tdarlic/magniplacer/feeders/PushPullFeeder-assembly.png

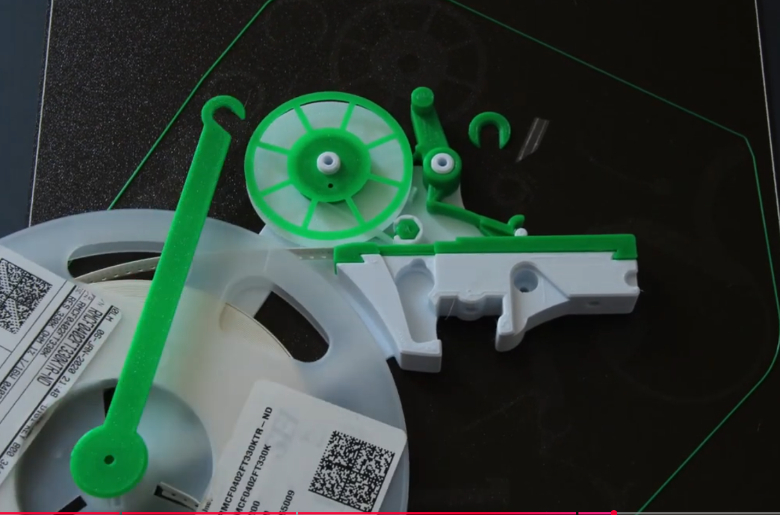
feeders/PushPullFeeder-assembly.png
