tdarlic/magniplacer/images/o-ring-image-on-ruler.jpg

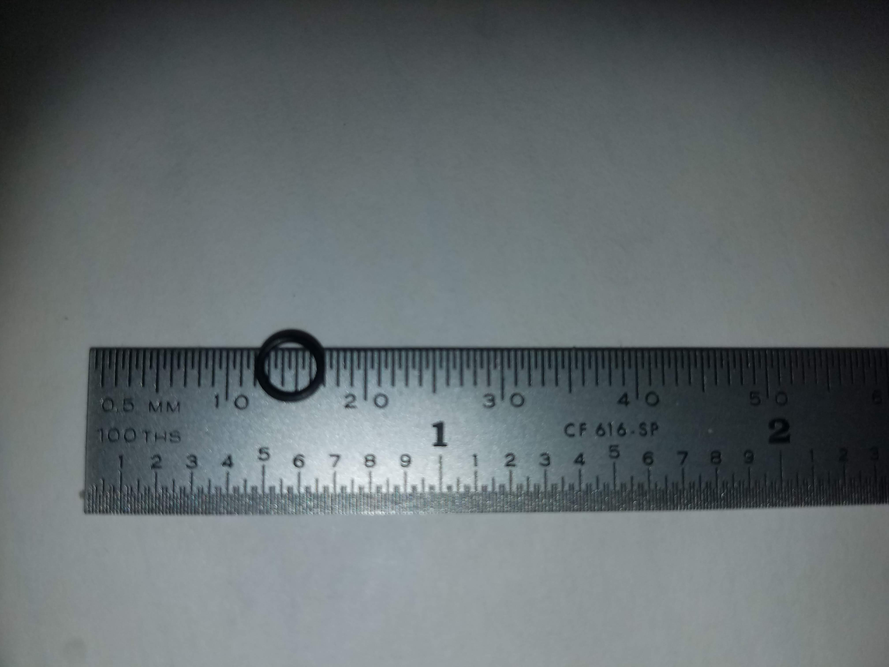
images/o-ring-image-on-ruler.jpg
