tdarlic/magniplacer/openpnp-machine-notes.md

# OpenPnP machine – upgrade to 2.6, cameras, lighting and vacuum sensing

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

**Contents**

1. [Machine overview and access](#1-machine-overview-and-access)
2. [Upgrade from OpenPnP v1 to 2.6](#2-upgrade-from-openpnp-v1-to-26)
3. [Bottom (up-looking) camera – placement and height](#3-bottom-up-looking-camera--placement-and-height)
4. [Bottom camera – alignment and calibration](#4-bottom-camera--alignment-and-calibration)
5. [Bottom camera lighting](#5-bottom-camera-lighting)
6. [Vacuum sensing – design](#6-vacuum-sensing--design)
7. [Vacuum sensing – as built on this machine](#7-vacuum-sensing--as-built-on-this-machine)
8. [Vacuum sensing – Smoothieware config](#8-vacuum-sensing--smoothieware-config)
9. [Vacuum sensing – OpenPnP config and part detection](#9-vacuum-sensing--openpnp-config-and-part-detection)
10. [Troubleshooting](#10-troubleshooting)
11. [Change log – what was changed on the machine](#11-change-log--what-was-changed-on-the-machine)
12. [Open items](#12-open-items)
13. [References](#13-references)

---

## 1. Machine overview and access

| Item | Value |
|---|---|
| PC | hostname `openpnp`, Ubuntu 24.04, `ssh tdarlic@192.168.0.185` (password login, no SSH key installed yet) |
| OpenPnP | 2.6 (`2.6_2026-03-01_12-37-59.5bd404c`), installed in `/opt/openpnp`, Java 21 (OpenJDK) |
| Live OpenPnP config | `~/.openpnp2/` |
| First-run default config | `~/.openpnp2-clean/` (untouched, for reference) |
| Old v1 config | USB stick `/media/tdarlic/0E86-A3E6/.openpnp/`; identical copy in `~/Documents/.openpnp/` (**not read by 2.6**) |
| Controller | Smoothieboard v1.1 (LPC1769), OpenPnP driver `GcodeAsyncDriver` named "GcodeDriver" |
| Smoothie config | `config.txt` on the Smoothie SD card; on the PnP PC it mounts as `/media/tdarlic/A620-C10D/config.txt` |
| Serial port | `/dev/ttyACM0`, 115200 baud (Smoothieboard USB `1d50:6015`) |
| Nozzle | `N` (id `N1`), `ContactProbeNozzle`, probe actuator `N1PROBE` (G38.2, reads P1.29 via M119) |
| Nozzle tips | 6 tips in an automatic tip changer: N045 (`NT1`), N40, N14, N24, N400, N750 (see below) |
| Top camera | `TOP CAMERA`, Logitech C270 (`046d:0825`), USB port `usb-0000:00:14.0-9`, 1280×960 |
| Bottom camera | `BOTTOM`, "HD USB Camera" (`05a3:9310`), USB port `usb-0000:00:14.0-2`, 960×720 |

### Actuators (v2 config)

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

### Configuration as checked on 2026-10-05

**Axes and motion** (`GcodeAsyncDriver`, motion control `ModeratedConstantAcceleration`, machine speed slider 100 %)

| Axis | Letter | Soft limits | Notes |
|---|---|---|---|
| x | X | 1 … 570 mm | **200 mm/s, 1200 mm/s²** (tested, 2026-10-05); backlash: one-sided, ≈ 0.127 mm |
| y | Y | 3 … 373 mm | **200 mm/s, 1200 mm/s²** (tested, 2026-10-05); backlash: one-sided, ≈ 0.127 mm |
| Z | Z | – | safe zone low −4.8 mm |
| C | A | −180 … 180° | rotation, wrap-around, limited |
| zTop / rotationTop | – | – | virtual axes for the top camera |

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

**Cameras**

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

Nozzle head offset (to the top camera): X −106.55, Y −35.47.

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

**Feeders and parts**

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

**Smoothie `config.txt`** (main values, file dated 2026-10-05 16:33)

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

### Working rules

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

---

## 2. Upgrade from OpenPnP v1 to 2.6

### Approach

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

### What was found

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

### Old v1 config – for reference

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

### What to carry over

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

### Suggested order

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

---

## 3. Bottom (up-looking) camera – placement and height

### The top and bottom cameras never need to look at each other

Both cameras are referenced to the **nozzle**, not to each other:

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

So what matters is where the **nozzle** can reach, not the top camera.

### Placement

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

### Height and focus

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

---

## 4. Bottom camera – alignment and calibration

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

**Reason:** two separate things decide that point:

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

**Procedure:**

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

**Investigate mechanically only if:**

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

---

## 5. Bottom camera lighting

### Decision

The bottom camera light was **changed from red LEDs to white LEDs.**

### Why white rather than red (or 617 nm "amber")

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

### Setting the brightness – not as bright as possible

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

Notes:

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

---

## 6. Vacuum sensing – design

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

**Parts:** NXP/Freescale **MPXV6115VC6U** vacuum sensor + Microchip **MCP6001UT-I/OT** op-amp.

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

### Signal chain

```
vacuum line ── MPXV6115V   (5 V supply, 4.6 V at atmosphere → 0.2 V at full vacuum)
                   │
             divider 51k / 100k  (× 0.662)  + RC low-pass
                   │
             MCP6001U voltage follower  (3.3 V supply, rail-to-rail)
                   │
             100 Ω → Smoothieboard P0.23 (T0 thermistor input, LPC1769 ADC 0–3.3 V)
                   │
             Smoothieware temperature_control (ad8495 = linear)  →  M105  →  OpenPnP actuator AVACS
```

### Design decisions

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

### Op-amp choice – history

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

### Schematic

```
 +5V (from Smoothie serial debug header – see §7)
  │
  ├──────────┬──────────────┐
  │          │              │
  │       C1 100nF       C2 1.5µF (optional, bulk)
  │          │              │
  │         GND            GND
  │
  │   ┌───────────────┐
  └───┤ 2  Vs         │
      │               │
      │  MPXV6115VC6U │ 4  Vout
      │  (U1)         ├──────┬────── R1 51k ─────┬────────────────┐
      │               │      │                  │                │
      │ 3  GND        │   C3 33pF           R2 100k    C4 22nF   │
      └──────┬────────┘      │                  │         │      │
             │              GND                GND       GND     │
            GND                                                  │
   (pins 1, 5, 6, 7, 8: leave unconnected)                       │
                                                                 │
 +3.3V (from Smoothie VBB/3.3V/GND connector – see §7)           │
   │                                                             │
   ├──────────────────────────────── 5  VDD                      │
   │                                                             │
 C5 100nF                   ┌─ 1  VIN+ ◄─────────────────────────┘
 (≤ 2 mm from pin 5)        │
   │                        │    MCP6001UT-I/OT  (U2, SOT-23-5)
  GND                       │
                       ┌─── 3  VIN−
                       │
                       │    4  VOUT ──┬── R3 100Ω ────► Smoothie P0.23 (T0 signal pin)
                       │              │
                       └──────────────┘
                            2  VSS ── GND
```

The MCP6001U is wired as a **voltage follower**: output connected straight to VIN−, gain = 1.

### Pinouts (checked against datasheets)

**MPXV6115VC6U (SOP-8, pin 1 marked by notch)**

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

**MCP6001UT-I/OT (SOT-23-5) – "U" variant**

| Pin | Function |
|---|---|
| 1 | VIN+ |
| 2 | VSS (GND) |
| 3 | VIN− |
| 4 | VOUT |
| 5 | VDD (+3.3 V) |

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

### Bill of materials

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

### Expected voltages

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

### Bench test (repeat after any repair)

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

---

## 7. Vacuum sensing – as built on this machine

### Electrical connections to the Smoothieboard v1.1

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

Notes:

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

### Air line

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

```
pump ── restriction (short section of thinner tube) ──┬── sensor (≈ 10 cm from the nozzle holder)
                                                      ├── vent valve AVAC (to outside air)
                                                      └── nozzle
```

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

It works like an air version of a voltage divider:

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

Tuning:

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

### Measured readings (smallest nozzle tip NT1, restriction fitted)

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

Larger tips will read closer to 614 when empty, so their gap will be bigger.

---

## 8. Vacuum sensing – Smoothieware config

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

```
temperature_control.vacuum.enable          true
temperature_control.vacuum.sensor          ad8495
temperature_control.vacuum.ad8495_pin      0.23      # ADC pin of the thermistor input used (T0)
temperature_control.vacuum.ad8495_offset   0
temperature_control.vacuum.designator      V
temperature_control.vacuum.heater_pin      nc
temperature_control.vacuum.max_temp        1000      # MUST be above 660 - see instructions
```

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

---

## 9. Vacuum sensing – OpenPnP config and part detection

### Applied to `~/.openpnp2/machine.xml` (2026-09-29)

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

The XML added to the driver's `<commands>`, in case it needs to be recreated:

```xml
<command head-mountable-id="A1" type="ACTUATOR_READ_COMMAND">
   <text><![CDATA[M105 ; read vacuum sensor]]></text>
</command>
<command head-mountable-id="A1" type="ACTUATOR_READ_REGEX">
   <text><![CDATA[.*V:(?<Value>-?\d+\.?\d*).*]]></text>
</command>
```

### Starting part-detection values – nozzle tip NT1 (set in the GUI)

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

### What is actually configured (checked 2026-10-05)

The starting values above were **not** applied as written. Current settings in `machine.xml`:

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

### Setting up another nozzle tip

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

---

## 10. Troubleshooting

| Symptom | Likely cause |
|---|---|
| Op-amp output stuck at 3.3 V at atmosphere | Divider not working (R1 missing or wrong – this happened during the build) |
| VOUT doesn't follow VIN+ | Wrong MCP6001 variant (plain or R instead of U), or VIN− not tied to VOUT |
| Machine HALTs after boot | `max_temp` missing or below 660 in the `vacuum` section |
| AVACS reads nothing / error | Regex doesn't match: set driver log level to TRACE and check the `M105` reply. Or Smoothie not reset after editing `config.txt` |
| Reading doesn't change | Wrong ADC pin in config, sensor pins 1/5–8 connected, sensor 5 V missing |
| Same reading with tip open and blocked | Restriction between pump and line missing or too wide |
| Reading stuck at ~3.3 V (≈ 660) | Divider R2 missing, or sensor output disconnected |
| Reading stuck near 0 V | Sensor 5 V missing, R1 open, or op-amp not powered |
| Noisy reading | Missing C4/C5, pump/valve/motor current in the sensor ground wire, cable next to stepper cables |
| Reading drifts over time | 5 V not stable (USB power), sensor warming up |
| Output oscillates (check with a scope) | R3 missing or shorted |
| Vacuum builds too slowly / weak pick | Restriction too narrow; leaks in tubing |
| Op-amp or Smoothie dead after rework | Check the VBB/3.3V/GND connector wiring – VBB on the 3.3 V wire |
| Smoothie gives no serial port (`ttyACM0`) and no SD drive; PC log shows `Product: Smoothie`, `Manufacturer: SmoothieWare`, `bcdDevice 0.40` instead of `Smoothieboard` / `Uberclock` | Board waiting in its bootloader. **Most likely cause: e-stop pressed at power-up.** The e-stop is on `kill_button_pin 2.12`, the same pin as the board's play button, which (probably) makes the bootloader wait. Release the e-stop and reset / power-cycle. If it still stays in the bootloader: copy `FIRMWARE.CUR` to `firmware.bin` on the SD card to reflash (2026-10-05) |
| PC says the Smoothie SD card "was not properly unmounted" | The card's FAT dirty flag. Close OpenPnP, `udisksctl unmount -b /dev/sdb1`, `sudo fsck.vfat -a /dev/sdb1`, reset the board. After editing `config.txt` run `sync` before resetting |

---

## 11. Change log – what was changed on the machine

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

---

## 12. Open items

### Next session (2026-10-06): bottom camera Advanced Calibration

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

Before starting:

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

Calibration with a larger tip:

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

Afterwards:

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

### Other open items

- [x] ~~Actuators without a driver~~: PUMP, AVAC, LIGHT_TOP and LIGHT_BOTTOM still have no `driver-id`, but the
      log (2026-10-05) shows their G-code is sent. Nothing to fix. Optionally assign the GcodeDriver for tidiness.
- [x] Bottom camera added, Advanced Camera Calibration enabled, nozzle tip calibration running (N40).
- [ ] **Bottom camera Advanced Calibration is off** (2026-10-05) – redo it, see the checklist at the top of this
      section.
- [x] Top camera Advanced Camera Calibration done and enabled (2026-10-05 19:34, RMS 1.89 px).
- [ ] Set the bottom camera exposure and lighting (§5), then recalibrate.
- [ ] Part detection: set up N045 properly (its method is Difference with no limits). Measure N40 empty and with
      a part, then lower its Part On high limit (590). Set up the other tips. Test with a pick from an empty slot.
- [ ] Confirm what `M800` does to AVAC: does it close the vent? OpenPnP has it on while holding a part.
- [ ] Decide whether the pump runs constantly or is switched for each pick. If switched, set a pump-on wait (§7).
- [ ] Re-copy `machine.xml` into this folder after closing OpenPnP, so the vacuum fix from 2026-10-05 is included.
- [ ] Merge the rest of the v1 `parts.xml` / `packages.xml` into `~/.openpnp2` (only 6 parts so far).
- [ ] Recreate the 15 production strip feeders (table in §2). Only `Upper Strips - 1` exists.
- [ ] Check that the Smoothie 5 V rail isn't fed only from USB.
- [ ] E-stop box: add an indicator LED that shows when the e-stop is pressed. Use a separate NO contact block, with
      the LED on 24 V (24 V indicator, or LED + 2.2 kΩ 0.5 W). **Never load the P2.12 signal line**: it's only held
      high by a pull-up, and an LED there can make the board read "pressed" (machine halts, or stays in the
      bootloader at power-up). Consider also cutting the 24 V motor supply with the e-stop (relay/contactor); the
      kill button is only a firmware halt.
- [x] **Lost steps at 100 % speed** – **solved 2026-10-05**, settings applied at 19:10 (see the end of this item) (fine at 80 %, which also means 64 % acceleration – OpenPnP scales acceleration
      by speed²). X/Y motors are 17HM19-2004S (0.9°, 2.0 A) but run at 0.5 / 0.6 A (`alpha/beta_current`).
      Raise the current, then run `scripts/Speed_Test.js` (copy to `~/.openpnp2/scripts/`). It steps up feed rate
      and acceleration and checks the homing fiducial after each step. Set the axis limits from the result.
      Also: 333 mm/s × 320 steps/mm ≈ 107 kHz, which is above `base_stepping_frequency 100000`.
      Status 2026-10-05: more current made it *worse* (1.2 A clicking at standstill, 0.9 A large lost steps even at
      100 mm/s / 500 mm/s²). Not the supply (Artesyn LCM600Q, 24 V 23 A) and not driver heat (heatsinks fitted).
      Still to check: motor connectors and wiring, the board. At 0.5 / 0.6 A, Y drifted ≈ 0.02 mm per test step at
      every speed → check the Y pulley grub screws and belt tension. Next: baseline speed test at 0.5 / 0.6 A.
      **Finding 2026-10-05 18:33:** the speed test moves at 100 mm/s were fine, but the move back to the fiducial at
      the normal limits (`F29743` requested → Smoothie cap 333 mm/s, only 781 mm/s²) lost so many steps that the
      fiducial was out of view. So **top speed is the problem, not acceleration**: OpenPnP X/Y feed rate is
      15000 mm/s (= unlimited), so every long move runs at Smoothie's 333 mm/s (≈ 500 rpm, ≈ 107 kHz step rate).
      The 0.9 A run failed the same way, so it doesn't prove that more current is worse. Fix: limit the X/Y feed rate
      in OpenPnP (Machine Setup → Axes → x / y → Feed Rate [/s]) to what the speed test shows is safe.
      **Speed test 2026-10-05 18:38** (0.5 / 0.6 A, 1000 mm/s², `speed-test-2026-10-05_1838.csv`): 100, 150, 200
      and 250 mm/s all OK (shift ≤ 0.02 mm = noise, Y drift gone); 300 mm/s lost steps badly (fiducial lost).
      → Set X/Y feed rate **200 mm/s** in OpenPnP and `x/y_axis_max_speed 15000` (250 mm/s) in Smoothie.
      **Acceleration test 2026-10-05 18:52** (200 mm/s, `speed-test-2026-10-05_1852.csv`): 1000, 1500, 2000 mm/s²
      OK (≤ 0.02 mm); 3000 mm/s² lost steps in the first cycle (Y +4.0 mm, X −0.7 mm).
      → Chosen settings: **X/Y 200 mm/s, 1200 mm/s²** (60 % of the last good acceleration).
      OpenPnP: x / y Feed Rate [/s] 200, Acceleration [/s²] 1200. Smoothie: `x/y_axis_max_speed 15000`,
      `acceleration 1200` (used for moves OpenPnP doesn't send an M204 with, e.g. manual G-code).
      **Confirmed 2026-10-05 19:00** (`speed-test-2026-10-05_1900.csv`): 10 cycles at 200 mm/s / 1200 mm/s², total
      shift 0.022 mm (= noise) → no lost steps. **Applied 19:10:** OpenPnP x / y 200 mm/s, 1200 mm/s²; Smoothie
      `x/y_axis_max_speed 15000`, `acceleration 1200`. Copies in this folder: `machine.xml`, `smoothie-config.txt`.
      Optional later: re-test 250/300 mm/s at 0.9 A to confirm the step-rate limit, and the 0.9 A stuttering.
- [x] ~~X/Y low soft limits were switched off~~ (seen in the 18:25 save) – turned back on, saved 19:15.
      **Most likely cause of the 300 mm/s limit: Smoothie's step rate.** `base_stepping_frequency 100000` is the
      Smoothieware default and "the only officially supported value" (smoothieware.org/configuration-options).
      Step pulses are derived from that 10 µs tick by integer division, so the max step rate per motor is
      100000 / 320 = **312 mm/s**, and close to it the step timing becomes very uneven (300 mm/s = 96 kHz).
      Smoothie's `x/y_axis_max_speed 20000` (333 mm/s) is above what it can step. Torque is less likely: X/Y run
      at only ≈ 450 rpm at 300 mm/s (0.9°, 1/32 microstepping, 40 mm/rev). A re-test of 250/300 mm/s at 0.9 A
      would confirm: if 300 still fails, it's the step rate. Going faster needs fewer steps/mm (1.8° motors →
      160 steps/mm → 625 mm/s max), not more current.
- [ ] Optional: `ssh-copy-id tdarlic@192.168.0.185` for password-free access (still no key installed).
- [x] ~~Delete the big vision debug image folder~~: `ImageWriteDebug` is gone. `VisionSolutions` is now 1.7 GB;
      exclude it from backups or clean it up.

---

## 13. References

- Vacuum sensor PCB document: `vacuum-sensor.md` (GitHub vacuum sensor PCB project)
- Reference copy of the OpenPnP machine config: `machine.xml` (this folder; live file is `~/.openpnp2/machine.xml`)
- OpenPnP 2.0 upgrade notes: `/opt/openpnp/OPENPNP_2_0.md` on the PnP PC
- OpenPnP wiki – Vacuum Sensing: <https://github.com/openpnp/openpnp/wiki/Setup-and-Calibration_Vacuum-Sensing>
- Smoothieware temperature control (incl. AD8495 section): <https://smoothieware.org/temperaturecontrol>
- Microchip MCP6001/1R/1U/2/4 datasheet (DS20001733L):
  <https://ww1.microchip.com/downloads/en/DeviceDoc/MCP6001-1R-1U-2-4-1-MHz-Low-Power-Op-Amp-DS20001733L.pdf>
- Microchip MCP6006/6R/6U/7/9 datasheet (MCP6007 alternative):
  <https://ww1.microchip.com/downloads/aemDocuments/documents/APID/ProductDocuments/DataSheets/MCP6006-6R-6U-7-9-Data-Sheet-20006411B.pdf>
- Freescale/NXP MPXV6115V datasheet (Rev 3): <https://docs.rs-online.com/6ca8/0900766b810bd3f3.pdf>
- ST datasheet for MPXV6115V6 / MPXV6115VC6 (second source): <https://www.st.com/resource/en/datasheet/mpxv6115v6.pdf>
