tdarlic/magniplacer/feeders/push-pull-feeder-liteplacer-adapter.png

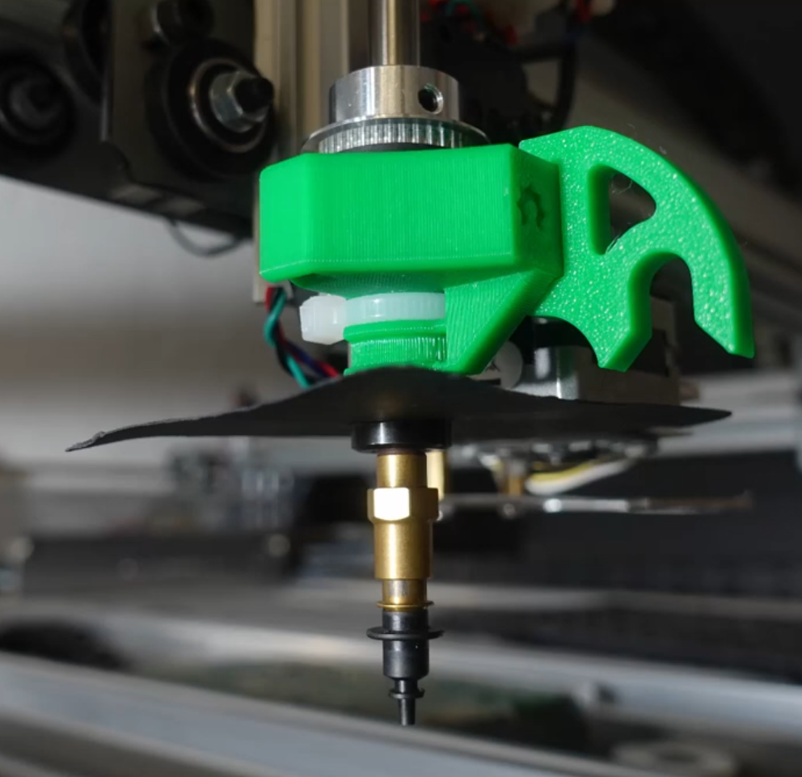
feeders/push-pull-feeder-liteplacer-adapter.png
