tdarlic/magniplacer/images/nozzle_with_ring_off.jpg

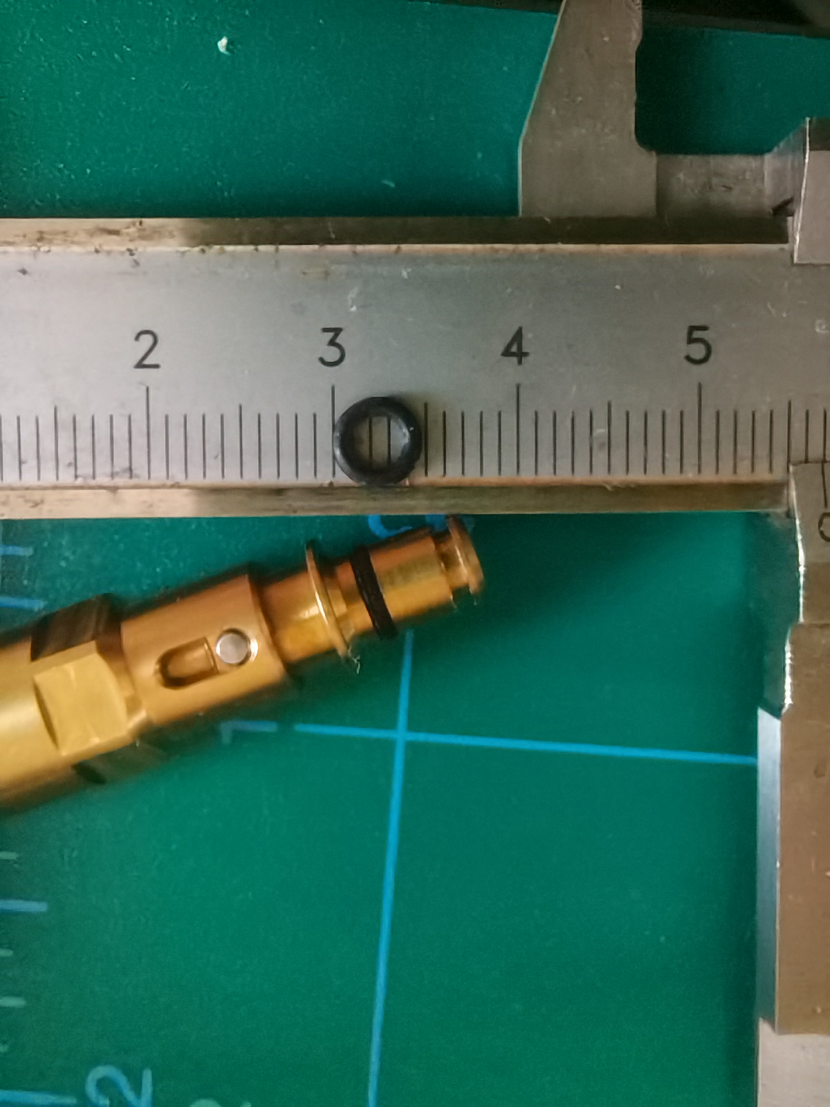
images/nozzle_with_ring_off.jpg
