tdarlic/magniplacer/images/o-ring.jpg

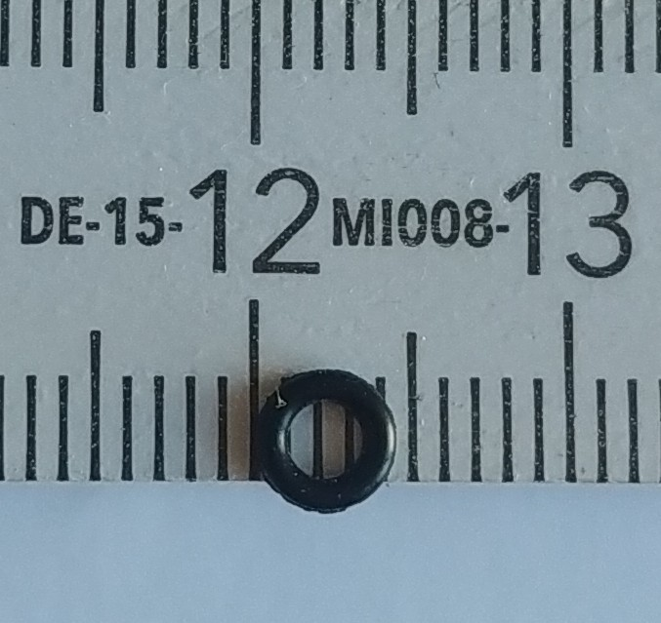
images/o-ring.jpg
