tdarlic/magniplacer/images/Seal_size_3.8-5.2mm.png

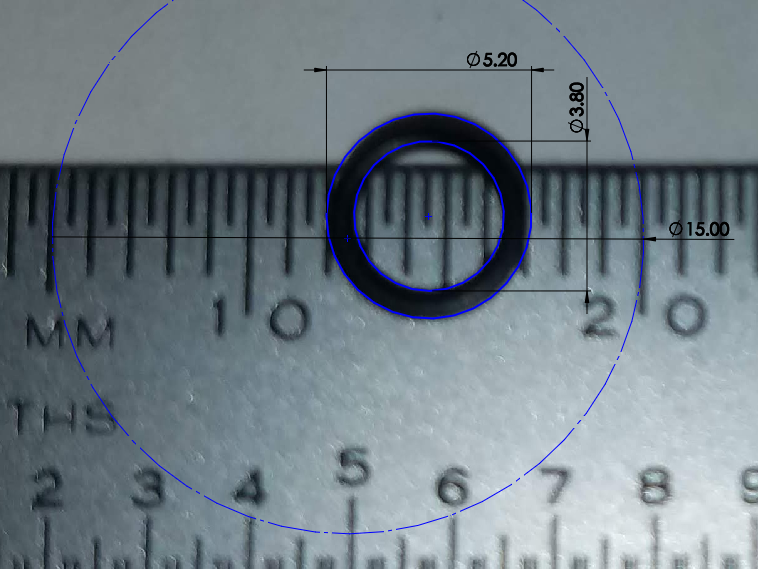
images/Seal_size_3.8-5.2mm.png
