tdarlic/magniplacer/images/spare_bag.jpg

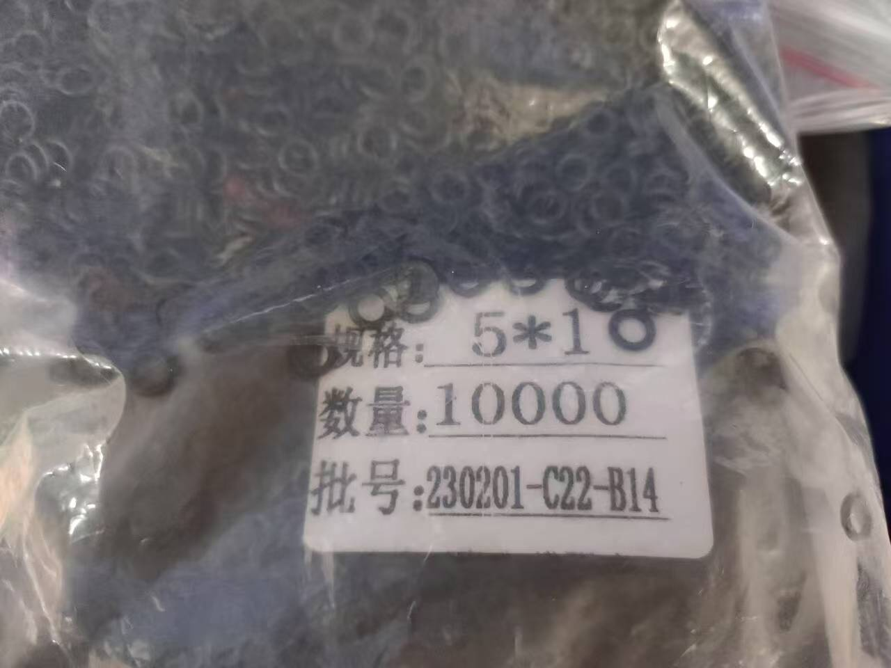
images/spare_bag.jpg
