tdarlic/magniplacer/feeders/sFeeder.stl

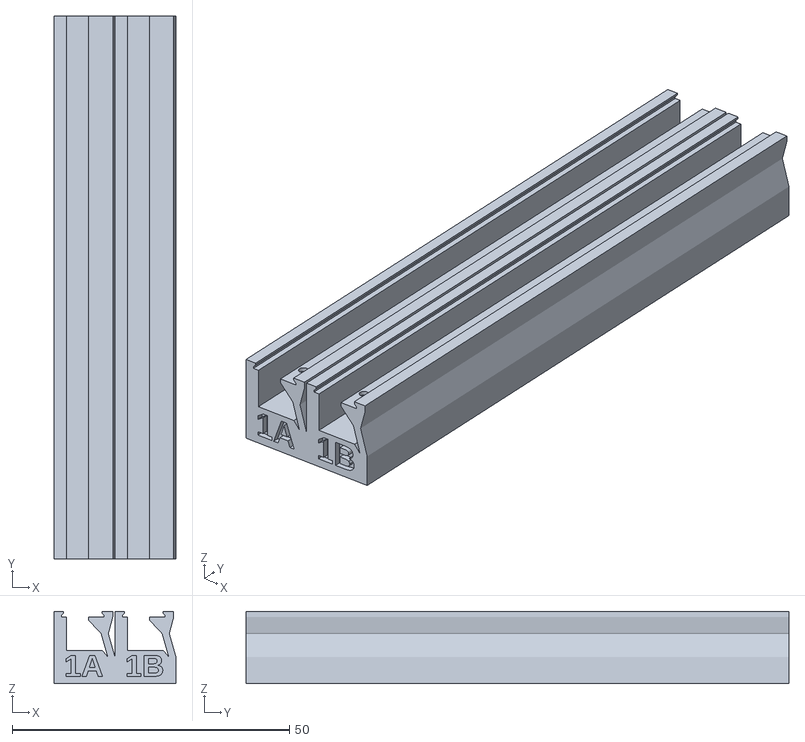
[picture p8: CAD file, 2026-10-12]
feeders/sFeeder.stl
22.0 x 98.0 x 13.0
