tdarlic/magniplacer/(list of files, cad)

Other CAD files:
feeders/sFeeder_screws_with_clearance_or_magnets.scad
