tdarlic/magniplacer/speed-test-2026-10-05_1728.csv

step | feed_mm_s | accel_mm_s2 | dx_mm | dy_mm | shift_mm | result
0 | baseline |  | 0 | 0 | 0.0129 | spread
1 | 100 | 500 | 0.0172 | -0.0058 | 0.0181 | ok
2 | 150 | 1000 | 0.0172 | -0.0273 | 0.0323 | ok
3 | 200 | 1500 | 0.0215 | -0.0489 | 0.0534 | lost
