tdarlic/magniplacer/speed-test-2026-10-05_1838.csv

step | feed_mm_s | accel_mm_s2 | step_dx_mm | step_dy_mm | step_shift_mm | total_dx_mm | total_dy_mm | total_shift_mm | result
0 | baseline |  | 0 | 0 | 0.0173 | 0 | 0 | 0 | spread
1 | 100 | 1000 | -0.0114 | -0.0101 | 0.0152 | -0.0114 | -0.0101 | 0.0152 | ok
2 | 150 | 1000 | 0.0129 | -0.0086 | 0.0155 | 0.0014 | -0.0187 | 0.0188 | ok
3 | 200 | 1000 | 0.0172 | -0.0043 | 0.0177 | 0.0186 | -0.0230 | 0.0296 | ok
4 | 250 | 1000 | 0.0043 | 0.0000 | 0.0043 | 0.0229 | -0.0230 | 0.0325 | ok
