tdarlic/magniplacer/speed-test-2026-10-05_1852.csv

step | feed_mm_s | accel_mm_s2 | step_dx_mm | step_dy_mm | step_shift_mm | total_dx_mm | total_dy_mm | total_shift_mm | result
0 | baseline |  | 0 | 0 | 0.0173 | 0 | 0 | 0 | spread
1 | 200 | 1000 | -0.0014 | -0.0115 | 0.0116 | -0.0014 | -0.0115 | 0.0116 | ok
2 | 200 | 1500 | -0.0172 | 0.0000 | 0.0172 | -0.0186 | -0.0115 | 0.0219 | ok
3 | 200 | 2000 | 0.0043 | 0.0000 | 0.0043 | -0.0143 | -0.0115 | 0.0184 | ok
4 | 200 | 3000 | -0.6779 | 4.0430 | 4.0994 | -0.6922 | 4.0315 | 4.0905 | lost drift
