tdarlic/magniplacer/speed-test-2026-10-05_1900.csv

step | feed_mm_s | accel_mm_s2 | step_dx_mm | step_dy_mm | step_shift_mm | total_dx_mm | total_dy_mm | total_shift_mm | result
0 | baseline |  | 0 | 0 | 0.0000 | 0 | 0 | 0 | spread
1 | 200 | 1200 | 0.0129 | -0.0173 | 0.0215 | 0.0129 | -0.0173 | 0.0215 | ok
