tdarlic/magniplacer/smoothie-config.txt

# NOTE Lines must not exceed 132 characters
# Robot module configurations : general handling of movement G-codes and slicing into moves
default_feed_rate                            20000            # Default rate ( mm/minute ) for G1/G2/G3 moves
default_seek_rate                            16000            # Default rate ( mm/minute ) for G0 moves

#switch off grbl mode
grbl_mode									 false

# Arm solution configuration : Cartesian robot. Translates mm positions into stepper positions
alpha_steps_per_mm                           320.07      # Steps per mm for alpha stepper
beta_steps_per_mm                            320.22          # Steps per mm for beta stepper
gamma_steps_per_mm                           812.7           # Steps per mm for gamma stepper

# Planner module configuration : Look-ahead and acceleration configuration
planner_queue_size                           32               # DO NOT CHANGE THIS UNLESS YOU KNOW EXACTLY WHAT YOU ARE DOING
acceleration                                 1200             # Acceleration in mm/second/second.
z_acceleration                               1000             # Acceleration for Z only moves in mm/s^2, 0 uses acceleration which is the default. DO NOT SET ON A DELTA
acceleration_ticks_per_second                1000             # Number of times per second the speed is updated
junction_deviation                           0.05                # Similar to the old "max_jerk", in millimeters,
                                                              # see https://github.com/grbl/grbl/blob/master/planner.c
                                                              # and https://github.com/grbl/grbl/wiki/Configuring-Grbl-v0.8
                                                              # Lower values mean being more careful, higher values means being
                                                              # faster and have more jerk
z_junction_deviation                        0.0              # for Z only moves, -1 uses junction_deviation, zero disables junction_deviation on z moves DO NOT SET ON A DELTA

# Stepper module configuration
microseconds_per_step_pulse                  1                # Duration of step pulses to stepper drivers, in microseconds
base_stepping_frequency                      100000           # Base frequency for stepping, higher gives smoother movement

# Cartesian axis speed limits
x_axis_max_speed                             15000            # mm/min
y_axis_max_speed                             15000            # mm/min
z_axis_max_speed                             15000            # mm/min

# Stepper module pins ( ports, and pin numbers, appending "!" to the number will invert a pin )
# X Axis
alpha_step_pin                               2.0              # Pin for alpha stepper step signal
alpha_dir_pin                                0.5!             # Pin for alpha stepper direction
alpha_en_pin                                 0.4              # Pin for alpha enable pin
alpha_current                                0.5              # X stepper motor current
alpha_max_rate                               30000.0          # mm/min

# Y Axis
beta_step_pin                                2.1              # Pin for beta stepper step signal
beta_dir_pin                                 0.11!            # Pin for beta stepper direction
beta_en_pin                                  0.10             # Pin for beta enable
beta_current                                 0.6              # Y stepper motor current
beta_max_rate                                30000.0          # mm/min

# Z Axis
gamma_step_pin                               2.2              # Pin for gamma stepper step signal
gamma_dir_pin                                0.20            # Pin for gamma stepper direction
gamma_en_pin                                 0.19             # Pin for gamma enable
gamma_current                                0.5             # Z stepper motor current
gamma_max_rate                               30000.0          # mm/min

# A axis
delta_steps_per_mm                           80.34               # steps per degree: 160Â° per rev. @0.9Â° stepper = 400 steps/160Â° x 16 micros = 40
delta_step_pin                               2.3              # Pin for delta stepper step signal
delta_dir_pin                                0.22!              # Pin for delta stepper direction
delta_en_pin                                 0.21               # Pin for delta enable
delta_current                                0.2              # Z stepper motor current
a_axis_max_speed                             60000           # Â°/min
delta_max_rate                               60000           # Â°/min
delta_acceleration                           5000.0# 36000.0          # Â°/sec^2

extruder.hotend.enable                       false             # Whether to activate the extruder module at all. All configuration is ignored if false
# extruder.hotend.steps_per_mm                 80.34           # Steps per mm for extruder stepper
# extruder.hotend.default_feed_rate            60000            # Default rate ( mm/minute ) for moves where only the extruder moves
# extruder.hotend.acceleration                 5000             # Acceleration for the stepper motor, as of 0.6, arbitrary ratio
# extruder.hotend.max_speed                    200              # mm/s
# extruder.hotend.step_pin                     2.3              # Pin for extruder step signal
# extruder.hotend.dir_pin                      0.22!             # Pin for extruder dir signal
# extruder.hotend.en_pin                       0.21             # Pin for extruder enable signal
# delta_current                                0.2              # First extruder stepper motor current

extruder.hotend2.enable                      false            # Whether to activate the extruder module at all. All configuration is ignored if false

# Serial communications configuration ( baud rate default to 9600 if undefined )
uart0.baud_rate                              115200           # Baud rate for the default hardware serial port
second_usb_serial_enable                     false            # This enables a second usb serial port (to have both pronterface
                                                              # and a terminal connected)
msd_disable                                 true            # disable the MSD (USB SDCARD) when set to true (needs special binary)
dfu_enable                                  false            # for linux developers, set to true to enable DFU


# Endstops
endstops_enable                              true             # the endstop module is enabled by default and can be disabled here
#endstop_debounce_count                       100              # uncomment if you get noise on your endstops, default is 100

# X
alpha_min_endstop                            1.24^!            # add a ! to invert if endstop is NO connected to ground
alpha_max_endstop                            1.25^!            # NOTE set to nc if this is not installed
alpha_homing_direction                       home_to_min      # or set to home_to_max and set alpha_max
alpha_min                                    0                # this gets loaded after homing when home_to_min is set
alpha_max                                    570              # this gets loaded after homing when home_to_max is set
alpha_max_travel                             600              # Max travel in mm for alpha/X axis when homing
alpha_fast_homing_rate_mm_s                  50               # feedrates in mm/second
alpha_slow_homing_rate_mm_s                  25               # "
alpha_homing_retract_mm                      5                # distance in mm

# Y
beta_min_endstop                             1.26^!              #
beta_max_endstop                             1.27^!            #
beta_homing_direction                        home_to_min      #
beta_min                                     0                #
beta_max                                     373              #
beta_max_travel                              400
beta_fast_homing_rate_mm_s                   50               # "
beta_slow_homing_rate_mm_s                   25               # "
beta_homing_retract_mm                       5                # "

# Z
gamma_min_endstop                            1.29^!           #
gamma_max_endstop                            1.28^!            #
gamma_homing_direction                       home_to_max      #
gamma_min                                    33            #
gamma_max                                    0              #
gamma_fast_homing_rate_mm_s                  50               # "
gamma_slow_homing_rate_mm_s                  25               # "
gamma_homing_retract_mm                      10               # "


# optional order in which axis will home, default is they all home at the same time,
# if this is set it will force each axis to home one at a time in the specified order
homing_order                                 ZXY              # z axis followed by x then y last

#Solenoid Switch
switch.n1_vac.enable                         true
switch.n1_vac.input_on_command               M800
switch.n1_vac.input_off_command              M801
switch.n1_vac.output_pin                     1.22
switch.n1_vac.output_type                    digital

#switch.n1_exh.enable                         true
#switch.n1_exh.input_on_command               M802
#switch.n1_exh.input_off_command              M803
#switch.n1_exh.output_pin                     2.5
#switch.n1_exh.output_type                    digital

#switch.n2_vac.enable                         false
#switch.n2_vac.input_on_command               M804
#switch.n2_vac.input_off_command              M805
#switch.n2_vac.output_pin                     2.4
#switch.n2_vac.output_type                    digital

#switch.n2_exh.enable                         false
#switch.n2_exh.input_on_command               M806
#switch.n2_exh.input_off_command              M807
#switch.n2_exh.output_pin                     2.6
#switch.n2_exh.output_type                    digital

#Vacuum Pump
switch.vac.enable                            true
switch.vac.input_on_command                  M808
switch.vac.input_off_command                 M809
switch.vac.output_pin                        2.6    #1.23
switch.vac.output_type                       digital

#Bottomm LEDs
switch.ledbtm.enable                            true
switch.ledbtm.input_on_command                  M810
switch.ledbtm.input_off_command                 M811
switch.ledbtm.output_pin                        2.5
switch.ledbtm.output_type                       digital

#Head LEDs
switch.ledtop.enable                            true
switch.ledtop.input_on_command                  M820
switch.ledtop.input_off_command                 M821
switch.ledtop.output_pin                        2.7
switch.ledtop.output_type                       digital

#Vacuum sensor
temperature_control.vacuum.enable          true
temperature_control.vacuum.sensor          ad8495
temperature_control.vacuum.ad8495_pin      0.23      # ADC pin of the thermistor input used (T0)
temperature_control.vacuum.ad8495_offset   0
temperature_control.vacuum.designator      V
temperature_control.vacuum.heater_pin      nc
temperature_control.vacuum.max_temp        1000      # MUST be above 660 - see instructions


# Only needed on a smoothieboard
currentcontrol_module_enable                 true             #

return_error_on_unhandled_gcode              false            #

# Kill button maybe assigned to a different pin, set to the onboard pin by default
# See http://smoothieware.org/killbutton
kill_button_enable                           true             # Set to true to enable a kill button
kill_button_pin                              2.12             # Kill button pin. default is same as pause button 2.12 (2.11 is another good choice)
kill_button_toggle_enable        true                # allows for latching estop button
