tdarlic/magniplacer/(commit log)

2026-10-05 Save configuration after speed and acc calibration
2026-10-05 Add latest changes to setup and failing bottom camera calibration
2026-10-07 Add comments about relay emergency stop
    Add datasheets of mosfet used in emergency stop and relay to be used
    (maybe) in emergency stop
2026-10-07 Setting up the z probing and nozzle changing
2026-10-07 Set Z probing to AfterHoming, document probe trigger delay
    - machine.xml: feeder and placement height probing EachTime -> AfterHoming
    (edited in the file, OpenPnP's Contact Probe tab can't save these fields)
    - machine.xml: nozzle tip calibration and part-on settings from the GUI
    - README: trigger delay d = 5.894 mm confirmed repeatable (< 0.1 mm),
    switch left as is; probing frequency options and per-feeder workaround
2026-10-08 Document bottom camera calibration, e-stop contactor and top camera swap
    - Bottom camera Advanced Calibration redone: RMS 1.74 px, enabled;
    todo to square up the camera mount (tilt 7.0 deg Y / 3.1 deg X)
    - E-stop: 24 V DC contactor (1NO + 1NC) as preferred alternative to
    the Schrack relay, wiring and notes
    - Top camera: Logitech C270 to be replaced by new ULP camera, checklist
2026-10-08 Plan iES-1706 Y servo and fail-safe kill loop on P1.30
    - New section 12: Leadshine iES-1706 for Y - pinout, FDN337N step/dir
    converter (DST-1R4P-N too slow for STEP), Smoothie config, ALM/PED
    - Specs checked against the iES-1706 datasheet (18-32 V DC, 200 kHz)
    - E-stop: fail-safe NC kill loop on P1.30 (JP32) with servo ALM in
    series; P2.10/2.11/2.12 ruled out from the board schematic
    - Fix: Smoothie clears the halt on e-stop release unless
    unkill_enable false
    - Todo: move kill input to P1.30; renumber sections 13-16
2026-10-10 Raise Safe Z to clear the nozzle changer, allow tall parts
    Safe Zone Low -4.8 -> -11.5 mm (nozzle ~1 mm above the changer holder),
    Z Soft Limit High +1.5 mm enabled, Dynamic Safe Z kept on. Parts up to
    ~11.4 mm can be picked, up to 8.25 mm with bottom vision. Documented in
    README section 11 and the change log.
2026-10-10 Tighten left Y belt, recalibrate Y backlash
    Left Y belt was loose. After tightening: Y backlash 0.132 mm
    (OneSidedPositioning), no calibration errors, and the home fiducial
    returns within 0.007 mm (was 0.16 mm). Next: re-run the 0603 job.
2026-10-11 Re-home on the proper fiducial and recalibrate the machine
    Set the homing fiducial where plain switch homing sees it. Smoothie had
    kept the G92 offset across G28, so positions drifted between sessions.
    Calibrate X/Y steps/mm against a steel ruler (320.07 / 320.22) and
    square the gantry. Then redo the calibration fiducials, top and bottom
    camera, nozzle offset, tip changer positions (Y -3.2), runout and X/Y
    backlash (one-sided, 0.150 mm).
2026-10-11 Add comments on the o-rings on the nozzle
